dh219/megabusmaster/kicad/megabusmaster.kicad_pcb

## KiCad design kicad/megabusmaster.kicad_pcb (2026-11-04)

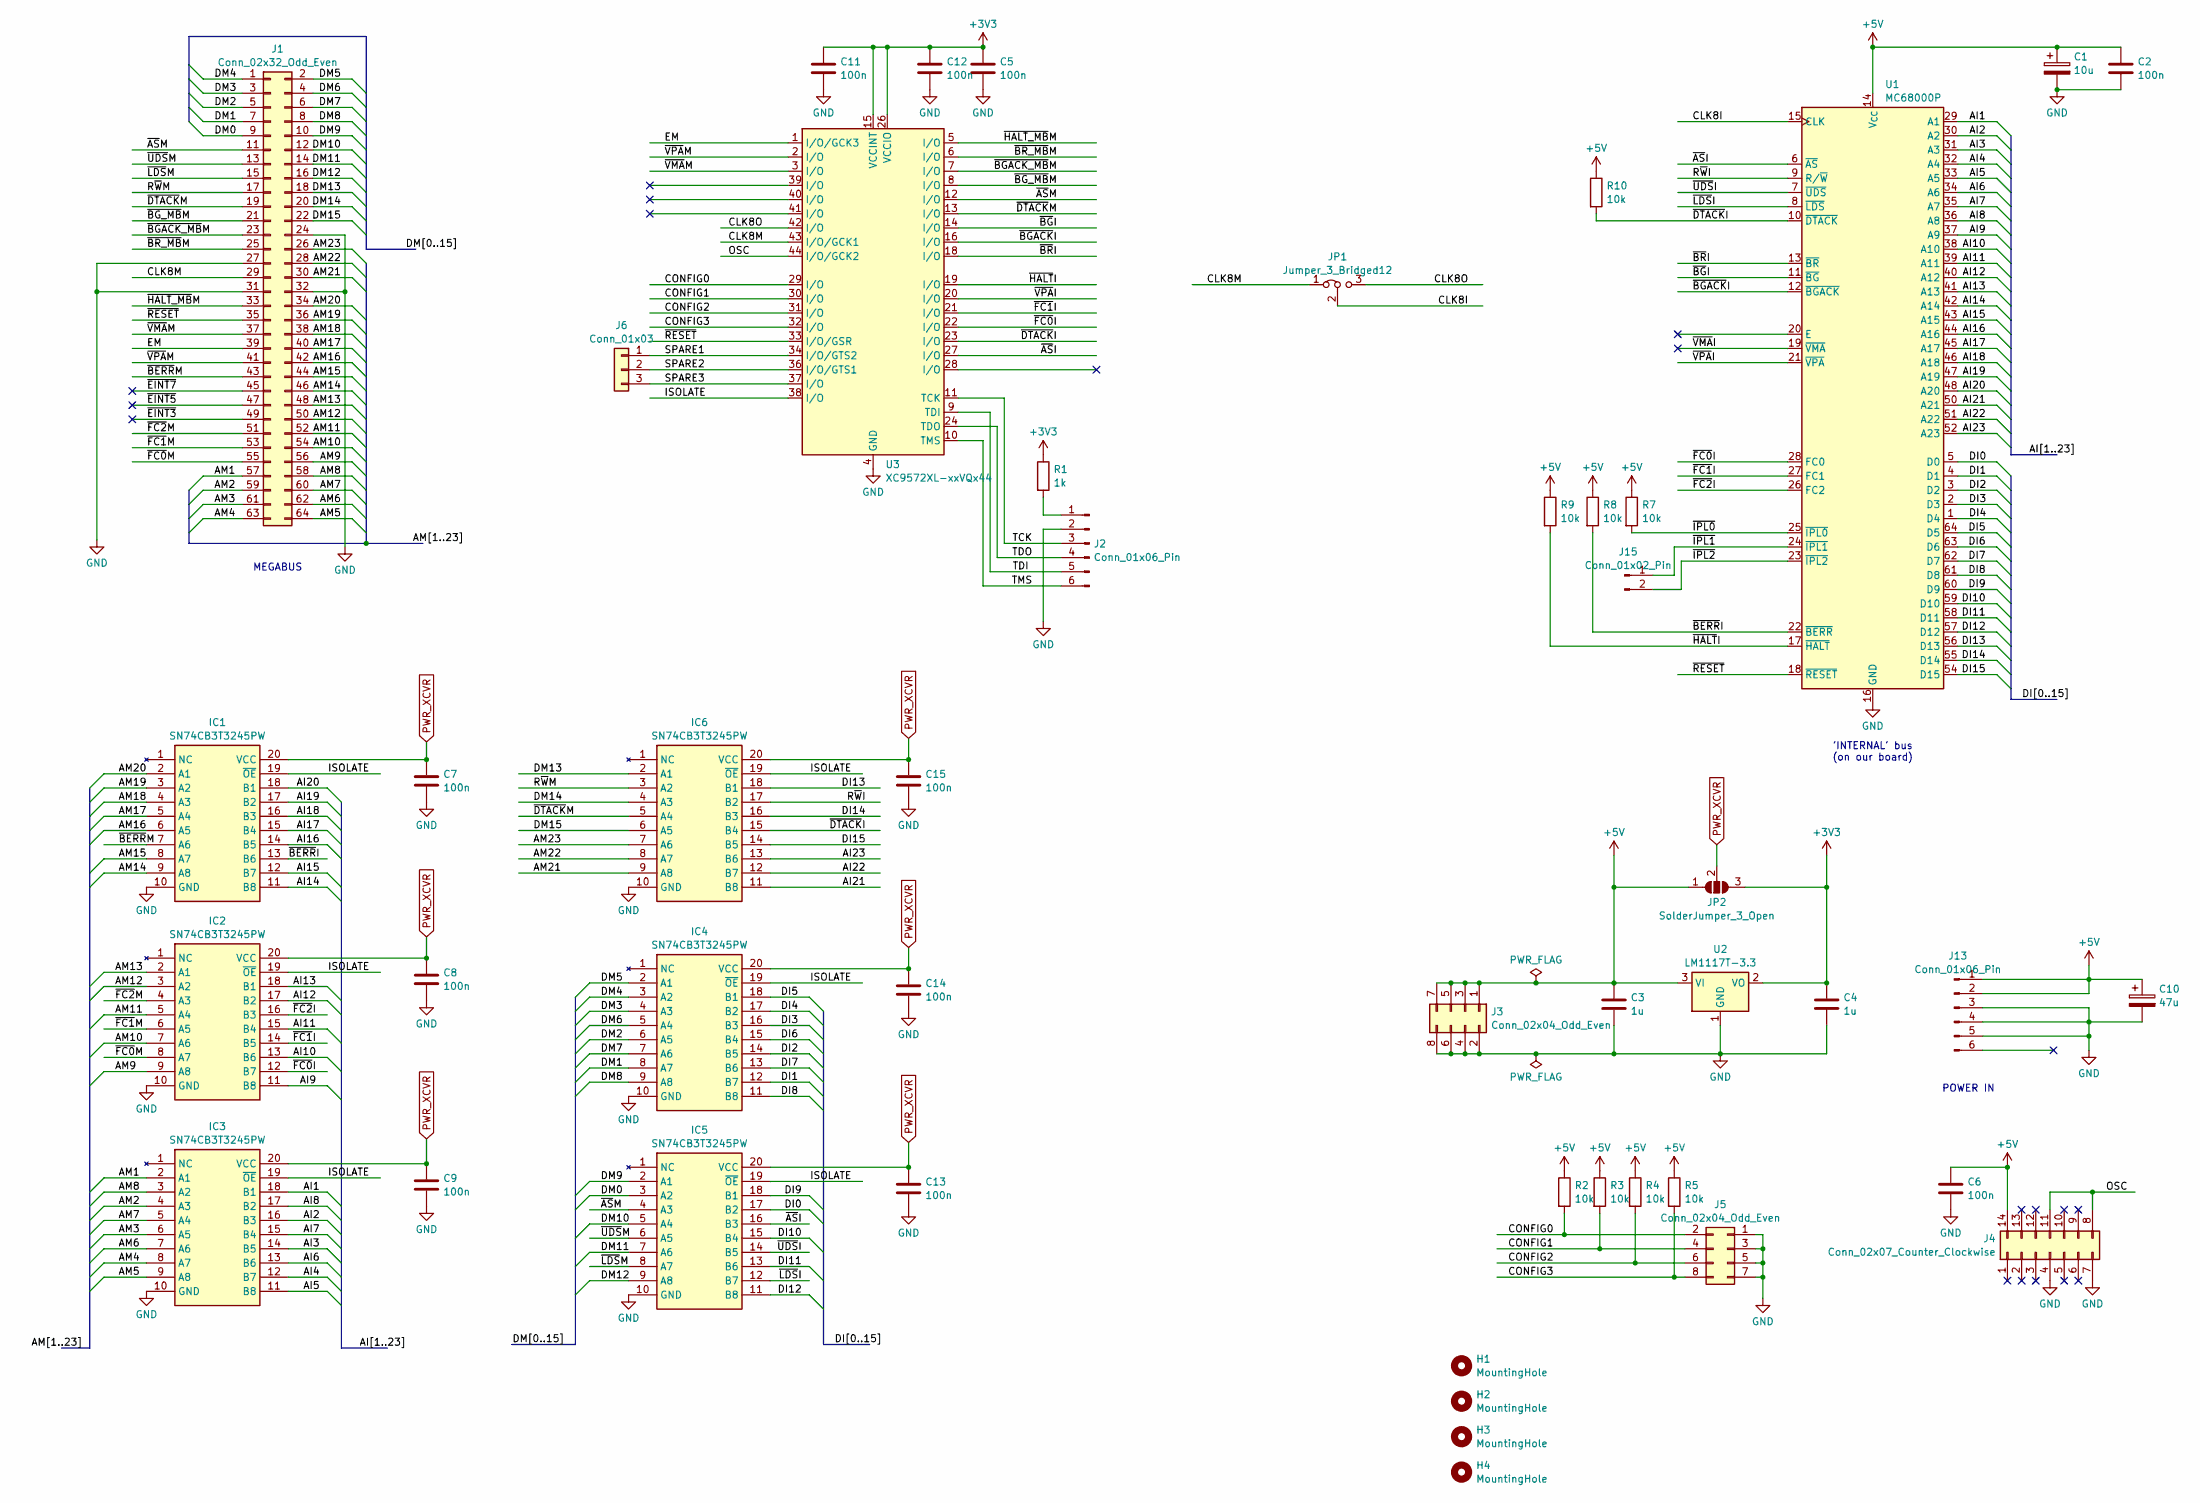
[picture p1: schematic megabusmaster.kicad_sch]

Parts:
C1: 10u; CP_Radial_D5.0mm_P2.50mm
C2, C5, C6, C7, C8, C9, C11, C12, C13, C14, C15: 100n; C_0805_2012Metric_Pad1.18x1.45mm_HandSolder
C3, C4: 1u; C_0805_2012Metric_Pad1.18x1.45mm_HandSolder
C10: 47u; CP_Radial_D5.0mm_P2.50mm
H1, H2, H3, H4: MountingHole; MountingHole_3.2mm_M3
IC1, IC2, IC3, IC4, IC5, IC6: SN74CB3T3245PW; TSSOP-20_4.4x6.5mm_P0.65mm; Manufacturer_Part_Number SN74CB3T3245PW; Mouser Part Number 595-SN74CB3T3245PW
J1: Conn_02x32_Odd_Even; PinSocket_2x32_P2.54mm_Vertical
J2, J13: Conn_01x06_Pin; PinHeader_1x06_P2.54mm_Vertical
J3, J5: Conn_02x04_Odd_Even; PinHeader_2x04_P2.54mm_Vertical
J4: Conn_02x07_Counter_Clockwise; DIP-14_W7.62mm_Socket
J6: Conn_01x03; SolderWire-0.25sqmm_1x03_P4.2mm_D0.65mm_OD1.7mm
J15: Conn_01x02_Pin; PinHeader_1x02_P2.54mm_Vertical
JP1: Jumper_3_Bridged12; PinHeader_1x03_P2.54mm_Vertical
JP2: SolderJumper_3_Open; SolderJumper-3_P1.3mm_Open_RoundedPad1.0x1.5mm
R1: 1k; R_0805_2012Metric_Pad1.20x1.40mm_HandSolder
R2, R3, R4, R5, R7, R8, R9, R10: 10k; R_0805_2012Metric_Pad1.20x1.40mm_HandSolder
U1: MC68000P; DIP-64_W22.86mm
U2: LM1117T-3.3; SOT-223-3_TabPin2
U3: XC9572XL-xxVQx44; TQFP-44_10x10mm_P0.8mm

Connections:
+3V3: C4.1, C5.1, C11.1, C12.1, JP2.3 (B), R1.1, U2.2 (VO), U3.15 (VCCINT), U3.26 (VCCIO), U3.35 (VCCINT)
+5V: C1.1, C2.1, C3.1, C6.1, C10.1, J3.1, J3.3, J3.5, J3.7, J4.14, J13.1, J13.2, JP2.1 (A), R2.1, R3.1, R4.1, R5.1, R7.1, R8.1, R9.1, R10.1, U1.14 (V_{CC}), U1.49 (V_{CC}), U2.3 (VI)
/AI1: IC3.18 (B1), U1.29 (A1)
/AI2: IC3.16 (B3), U1.30 (A2)
/AI3: IC3.14 (B5), U1.31 (A3)
/AI4: IC3.12 (B7), U1.32 (A4)
/AI5: IC3.11 (B8), U1.33 (A5)
/AI6: IC3.13 (B6), U1.34 (A6)
/AI7: IC3.15 (B4), U1.35 (A7)
/AI8: IC3.17 (B2), U1.36 (A8)
/AI9: IC2.11 (B8), U1.37 (A9)
/AI10: IC2.13 (B6), U1.38 (A10)
/AI11: IC2.15 (B4), U1.39 (A11)
/AI12: IC2.17 (B2), U1.40 (A12)
/AI13: IC2.18 (B1), U1.41 (A13)
/AI14: IC1.11 (B8), U1.42 (A14)
/AI15: IC1.12 (B7), U1.43 (A15)
/AI16: IC1.14 (B5), U1.44 (A16)
/AI17: IC1.15 (B4), U1.45 (A17)
/AI18: IC1.16 (B3), U1.46 (A18)
/AI19: IC1.17 (B2), U1.47 (A19)
/AI20: IC1.18 (B1), U1.48 (A20)
/AI21: IC6.11 (B8), U1.50 (A21)
/AI22: IC6.12 (B7), U1.51 (A22)
/AI23: IC6.13 (B6), U1.52 (A23)
/AM1: IC3.2 (A1), J1.57
/AM2: IC3.4 (A3), J1.59
/AM3: IC3.6 (A5), J1.61
/AM4: IC3.8 (A7), J1.63
/AM5: IC3.9 (A8), J1.64
/AM6: IC3.7 (A6), J1.62
/AM7: IC3.5 (A4), J1.60
/AM8: IC3.3 (A2), J1.58
/AM9: IC2.9 (A8), J1.56
/AM10: IC2.7 (A6), J1.54
/AM11: IC2.5 (A4), J1.52
/AM12: IC2.3 (A2), J1.50
/AM13: IC2.2 (A1), J1.48
/AM14: IC1.9 (A8), J1.46
/AM15: IC1.8 (A7), J1.44
/AM16: IC1.6 (A5), J1.42
/AM17: IC1.5 (A4), J1.40
/AM18: IC1.4 (A3), J1.38
/AM19: IC1.3 (A2), J1.36
/AM20: IC1.2 (A1), J1.34
/AM21: IC6.9 (A8), J1.30
/AM22: IC6.8 (A7), J1.28
/AM23: IC6.7 (A6), J1.26
/CLK8I: JP1.2 (C), U1.15 (CLK)
/CLK8M: J1.29, JP1.1 (A), U3.43 (I/O/GCK1)
/CLK8O: JP1.3 (B), U3.42 (I/O)
/CONFIG0: J5.2, R2.2, U3.29 (I/O)
/CONFIG1: J5.4, R3.2, U3.30 (I/O)
/CONFIG2: J5.6, R4.2, U3.31 (I/O)
/CONFIG3: J5.8, R5.2, U3.32 (I/O)
/DI0: IC5.17 (B2), U1.5 (D0)
/DI1: IC4.12 (B7), U1.4 (D1)
/DI2: IC4.14 (B5), U1.3 (D2)
/DI3: IC4.16 (B3), U1.2 (D3)
/DI4: IC4.17 (B2), U1.1 (D4)
/DI5: IC4.18 (B1), U1.64 (D5)
/DI6: IC4.15 (B4), U1.63 (D6)
/DI7: IC4.13 (B6), U1.62 (D7)
/DI8: IC4.11 (B8), U1.61 (D8)
/DI9: IC5.18 (B1), U1.60 (D9)
/DI10: IC5.15 (B4), U1.59 (D10)
/DI11: IC5.13 (B6), U1.58 (D11)
/DI12: IC5.11 (B8), U1.57 (D12)
/DI13: IC6.18 (B1), U1.56 (D13)
/DI14: IC6.16 (B3), U1.55 (D14)
/DI15: IC6.14 (B5), U1.54 (D15)
/DM0: IC5.3 (A2), J1.9
/DM1: IC4.8 (A7), J1.7
/DM2: IC4.6 (A5), J1.5
/DM3: IC4.4 (A3), J1.3
/DM4: IC4.3 (A2), J1.1
/DM5: IC4.2 (A1), J1.2
/DM6: IC4.5 (A4), J1.4
/DM7: IC4.7 (A6), J1.6
/DM8: IC4.9 (A8), J1.8
/DM9: IC5.2 (A1), J1.10
/DM10: IC5.5 (A4), J1.12
/DM11: IC5.7 (A6), J1.14
/DM12: IC5.9 (A8), J1.16
/DM13: IC6.2 (A1), J1.18
/DM14: IC6.4 (A3), J1.20
/DM15: IC6.6 (A5), J1.22
/EM: J1.39, U3.1 (I/O/GCK3)
/ISOLATE: IC1.19 (~OE), IC2.19 (~OE), IC3.19 (~OE), IC4.19 (~OE), IC5.19 (~OE), IC6.19 (~OE), U3.38 (I/O)
/OSC: J4.8, J4.11, U3.44 (I/O/GCK2)
/R~WI: IC6.17 (B2), U1.9 (R/~W)
/R~WM: IC6.3 (A2), J1.17
/SPARE1: J6.1, U3.34 (I/O/GTS2)
/SPARE2: J6.2, U3.36 (I/O/GTS1)
/SPARE3: J6.3, U3.37 (I/O)
/TCK: J2.3, U3.11 (TCK)
/TDI: J2.5, U3.9 (TDI)
/TDO: J2.4, U3.24 (TDO)
/TMS: J2.6, U3.10 (TMS)
/~ASI: IC5.16 (B3), U1.6 (~AS), U3.27 (I/O)
/~ASM: IC5.4 (A3), J1.11, U3.12 (I/O)
/~BERRI: IC1.13 (B6), R8.2, U1.22 (~BERR)
/~BERRM: IC1.7 (A6), J1.43
/~BGACK_MBM: J1.23, U3.7 (I/O)
/~BGACKI: U1.12 (~BGACK), U3.16 (I/O)
/~BG_MBM: J1.21, U3.8 (I/O)
/~BGI: U1.11 (~BG), U3.14 (I/O)
/~BR_MBM: J1.25, U3.6 (I/O)
/~BRI: U1.13 (~BR), U3.18 (I/O)
/~DTACKI: IC6.15 (B4), R10.2, U1.10 (~DTACK), U3.23 (I/O)
/~DTACKM: IC6.5 (A4), J1.19, U3.13 (I/O)
/~EINT3: J1.49
/~EINT5: J1.47
/~EINT7: J1.45
/~FC0I: IC2.12 (B7), U1.28 (FC0), U3.22 (I/O)
/~FC0M: IC2.8 (A7), J1.55
/~FC1I: IC2.14 (B5), U1.27 (FC1), U3.21 (I/O)
/~FC1M: IC2.6 (A5), J1.53
/~FC2I: IC2.16 (B3), U1.26 (FC2)
/~FC2M: IC2.4 (A3), J1.51
/~HALT_MBM: J1.33, U3.5 (I/O)
/~HALTI: R9.2, U1.17 (~HALT), U3.19 (I/O)
/~IPL0: R7.2, U1.25 (~IPL0)
/~IPL1: J15.1, U1.24 (~IPL1)
/~IPL2: J15.2, U1.23 (~IPL2)
/~LDSI: IC5.12 (B7), U1.8 (~LDS)
/~LDSM: IC5.8 (A7), J1.15
/~RESET: J1.35, U1.18 (~RESET), U3.33 (I/O/GSR)
/~UDSI: IC5.14 (B5), U1.7 (~UDS)
/~UDSM: IC5.6 (A5), J1.13
/~VMAI: U1.19 (~VMA)
/~VMAM: J1.37, U3.3 (I/O)
/~VPAI: U1.21 (~VPA), U3.20 (I/O)
/~VPAM: J1.41, U3.2 (I/O)
GND: C1.2, C2.2, C3.2, C4.2, C5.2, C6.2, C7.2, C8.2, C9.2, C10.2, C11.2, C12.2, C13.2, C14.2, C15.2, IC1.10 (GND), IC2.10 (GND), IC3.10 (GND), IC4.10 (GND), IC5.10 (GND), IC6.10 (GND), J1.24, J1.27, J1.31, J1.32, J2.2, J3.2, J3.4, J3.6, J3.8, J4.4, J4.7, J5.1, J5.3, J5.5, J5.7, J13.3, J13.4, J13.5, U1.16 (GND), U1.53 (GND), U2.1 (GND), U3.4 (GND), U3.17 (GND), U3.25 (GND)
unnamed: J2.1, R1.2
PWR_XCVR: C7.1, C8.1, C9.1, C13.1, C14.1, C15.1, IC1.20 (VCC), IC2.20 (VCC), IC3.20 (VCC), IC4.20 (VCC), IC5.20 (VCC), IC6.20 (VCC), JP2.2 (C)

Notes on the sheet:
POWER IN
'INTERNAL' bus (on our board)
MEGABUS

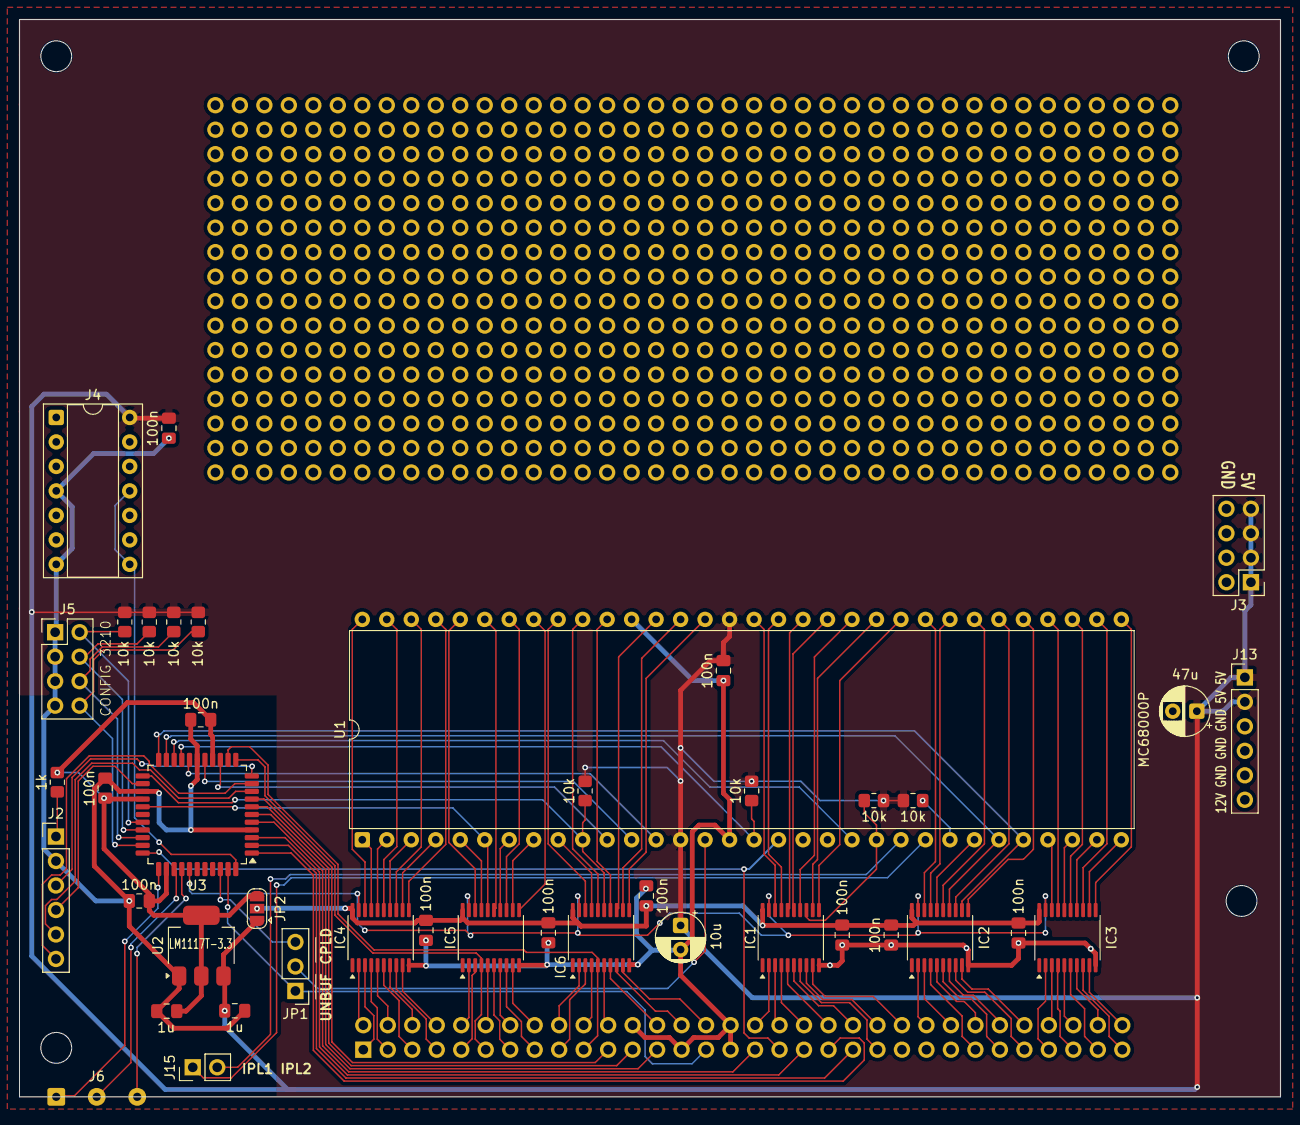
[picture p2: board megabusmaster.kicad_pcb from above]

Board: 2 copper layers, 130.8 x 111.8 mm, 47 parts (1 on the bottom side), 133 nets.
