dh219/megabusmaster/(commit log)

2026-09-10 First prototype version of megabusmaster nearly ready to order
    [megabusmaster.kicad_pcb, megabusmaster.kicad_sch]
2026-09-11 Version 0.1 as ordered.
    [megabusmaster.kicad_pcb]
2026-09-27 First version working without noticable slowdown. BR pull up, additional AS line, resets shorted and pull on HALT_I in place.
    [main_top.ucf, main_top.v]
2026-10-06 DSTB1 working nicely with an inverted clock and the external VPA hack.
    [main_top.ucf, main_top.v, vpahack.v]
2026-10-07 More tidying up of the code -- removing state machine numbers in the assignments. MiNT still not working, I'm suspecting my declaration program.
    [main_top.v]
2026-10-07 Missed one state dependency.
    [main_top.v]
2026-10-08 Reverted some changes that stopped the machine powering up with straight 68k and ruined the mouse and keyboard under MiNT. Need to revisit.
    [main_top.v]
2026-10-15 Initial attempt at second revision schematic.
2026-10-15 Started board layout of rev2
2026-10-20 Schematic DRC passing
2026-10-21 Nearly ready to order v0.2, but need to think about perhaps allowing voltage switching to the buffers.
